crazygo/ant-kettle-base-preview/README.md

# ant-kettle-base-preview
防蚁烧水壶台 v1.8 3D preview
