crazygo/ant-kettle-base-preview/models/ant_kettle_base_geometry.3mf

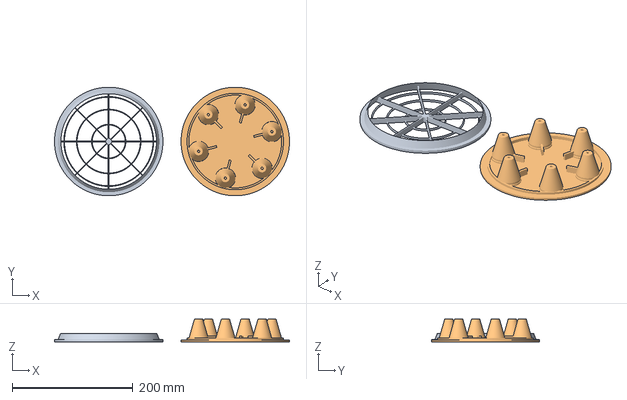
[picture p1: CAD file, 2026-10-10]
models/ant_kettle_base_geometry.3mf
390.0 x 180.0 x 38.0 mm
Lattice crown — contact face on bed; sloped internal roof; supports off
Integrated tray, membrane and hollow legs — legs upwards; supports off
