crazygo/ant-kettle-base-preview/models/01_upper_crown_print.stl

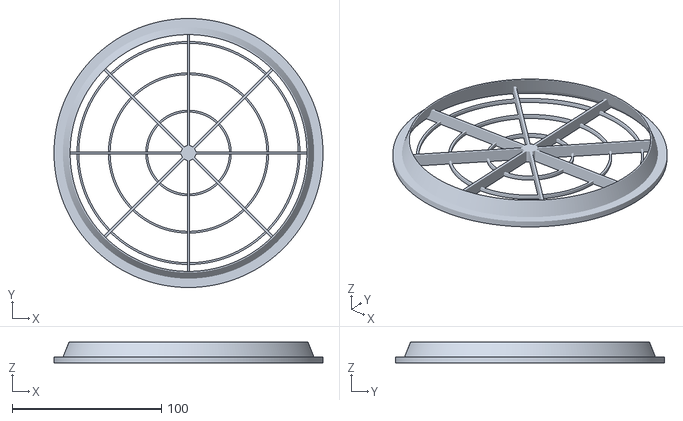
[picture p2: CAD file, 2026-10-10]
models/01_upper_crown_print.stl
180.0 x 180.0 x 14.0
