crazygo/ant-kettle-base-preview/models/02_lower_base_integrated_print.stl

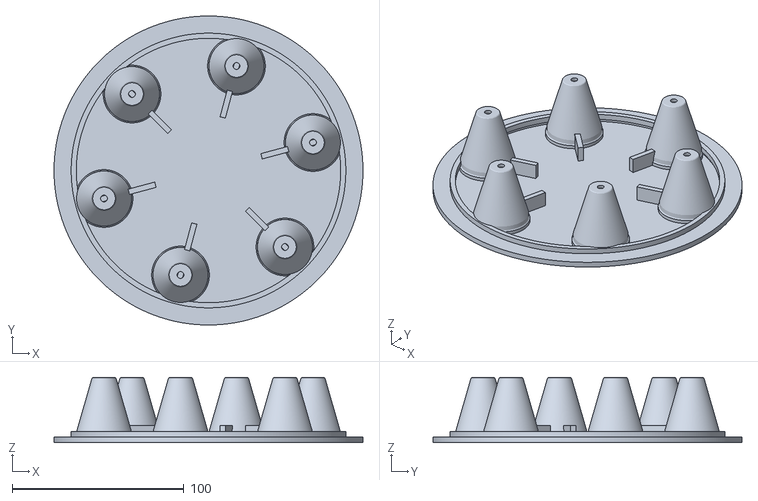
[picture p3: CAD file, 2026-10-10]
models/02_lower_base_integrated_print.stl
180.0 x 180.0 x 38.0
