crazygo/ant-kettle-base-preview/models/03_crown_surface_test_optional.stl

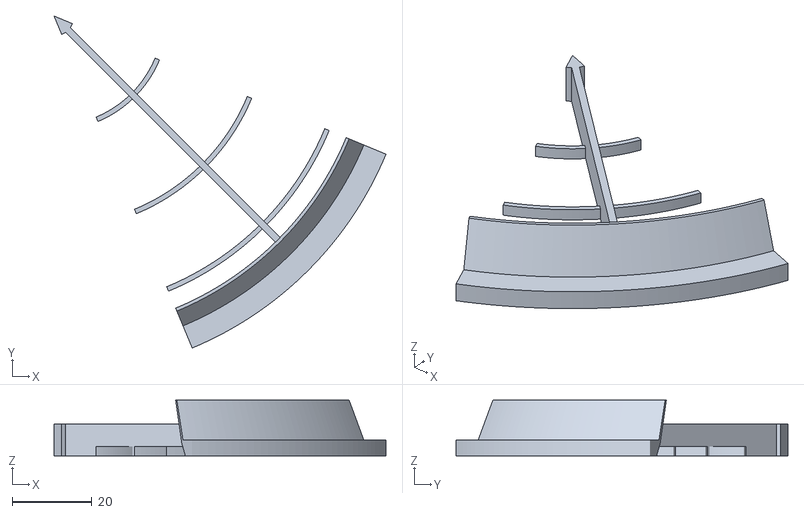
[picture p4: CAD file, 2026-10-10]
models/03_crown_surface_test_optional.stl
83.1 x 83.1 x 14.0
